ChenQiyue8/EE-242/README.md

# Arduometer
develope an tool that measures voltage and display digital reading through a Digital tube display
